anaguiar777/tcc-interface-musical-multissensorial/hardware/3d/README.md

# Invólucro 3D

Arquivos:

- `caixa_corpo.stl`
- `caixa_tampa.stl`

O corpo principal foi modelado para acomodar o conjunto eletrônico da unidade embarcada e a tampa permite acesso ao circuito para montagem e manutenção.

O desenvolvimento da geometria foi realizado de forma iterativa com apoio do ambiente Cursor durante a elaboração e os ajustes do modelo digital. As decisões de dimensão e adequação foram verificadas a partir dos componentes físicos do protótipo.

Envelope aproximado dos modelos:
- corpo: 84 × 64 × 52 mm;
- tampa: 84 × 64 × 5 mm.

As fotos da impressão e da disposição interna dos componentes serão adicionadas em `docs/fotos/`.

## Verificação dos arquivos originais

Após o upload, os arquivos podem ser conferidos pelos seguintes valores SHA-256:

| Arquivo | Tamanho | SHA-256 |
|---|---:|---|
| `caixa_corpo.stl` | 62.684 bytes | `c0678f162e2dd0e0683a15318d15398c387cd0960a7021f66101cb65fee5366b` |
| `caixa_tampa.stl` | 15.284 bytes | `076466b892219f54714d4bc5a69afdebfd9b1442e151f6ae7cfaafd1aea71c53` |

Esses hashes correspondem aos arquivos utilizados na documentação do projeto.
