anaguiar777/tcc-interface-musical-multissensorial/docs/fotos/README.md

# Fotografias do protótipo

Esta pasta será utilizada para documentar visualmente:

1. circuito em bancada;
2. ESP32 e estágio MOSFET;
3. sistema de baterias, BMS e MP1584EN;
4. caixa impressa em 3D;
5. disposição dos componentes dentro da caixa;
6. tampa e fechamento;
7. motor vibrotátil e LED;
8. unidade vestível final;
9. ensaio com MPD218.

Quando as fotografias forem adicionadas, o README principal poderá incorporar uma sequência visual de montagem.
