anaguiar777/tcc-interface-musical-multissensorial/hardware/BOM.md

# Lista de materiais

## Controlador e processamento
- 1 × Akai MPD218
- 1 × ESP32
- 1 × computador com Python 3
- rede Wi‑Fi local ou hotspot

## Canal vibrotátil
- 1 × motor Vibracall 1027
- 1 × MOSFET IRLZ44N
- 1 × resistor de 220 Ω
- 1 × resistor de 47 kΩ
- 1 × diodo Schottky 1N5819

## Canal visual
- 1 × LED de alto brilho
- 1 × resistor de 220 Ω

## Alimentação embarcada
- 2 × células Li‑ion 18650, 3,7 V nominal, em configuração 2S
- 1 × BMS 2S compatível
- 1 × conversor DC–DC MP1584EN
- fios, conectores e chave, conforme a montagem

## Invólucro
- 1 × corpo impresso a partir de `hardware/3d/caixa_corpo.stl`
- 1 × tampa impressa a partir de `hardware/3d/caixa_tampa.stl`

## Instrumentos recomendados para montagem
- multímetro
- fonte de bancada para os primeiros testes, se disponível
- ferro de solda
- computador com VS Code + PlatformIO

> Antes de alimentar o ESP32 pelo conversor DC–DC, ajuste e confira a tensão de saída com multímetro.
