anaguiar777/tcc-interface-musical-multissensorial/hardware/3d/caixa_tampa.stl

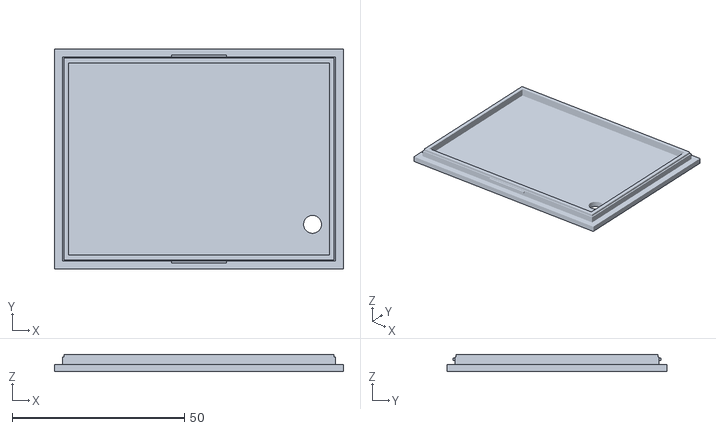
[picture p1: CAD file, 2026-10-28]
hardware/3d/caixa_tampa.stl
84.0 x 64.0 x 5.01
