anaguiar777/tcc-interface-musical-multissensorial/hardware/3d/caixa_corpo.stl

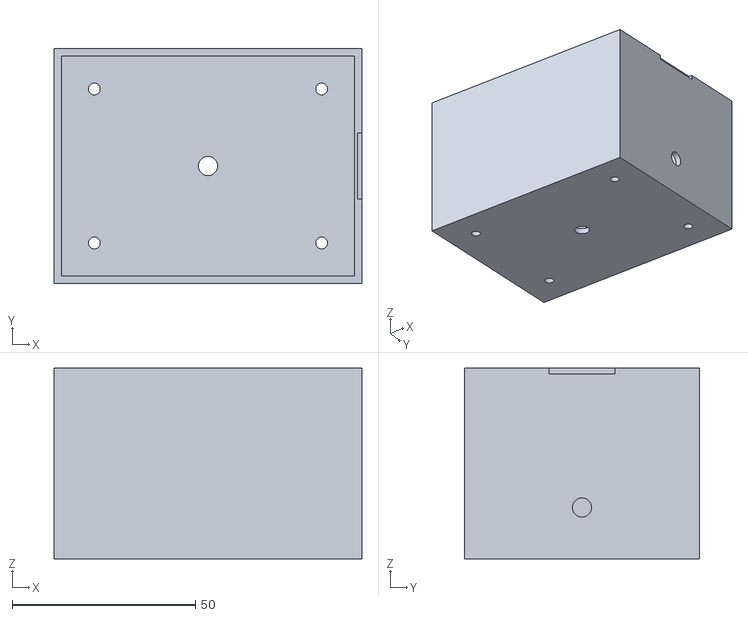
[picture p2: CAD file, 2026-10-28]
hardware/3d/caixa_corpo.stl
84.0 x 64.0 x 52.0
