anaguiar777/tcc-interface-musical-multissensorial/dados_experimentais/ensaio_acustico_resumo.csv

pwm | rep1_hz | rep2_hz | rep3_hz | media_hz | desvio_padrao_hz | coeficiente_variacao_percentual
80 | 91.5 | 92.9 | 90.2 | 91.5 | 1.35 | 1.5
115 | 106.3 | 127.9 | 126.5 | 120.2 | 12.09 | 10.1
150 | 145.3 | 154.8 | 165.5 | 155.2 | 10.11 | 6.5
185 | 173.6 | 191.1 | 196.5 | 187.1 | 11.97 | 6.4
220 | 203.2 | 212.6 | 216.7 | 210.8 | 6.92 | 3.3
255 | 224.8 | 227.4 | 231.5 | 227.9 | 3.38 | 1.5
