anaguiar777/tcc-interface-musical-multissensorial/dados_experimentais/ensaio_queda_resumo.csv

altura_cm | energia_potencial_J | velocity_media | velocity_mediana | velocity_desvio_padrao | pwm_media | pwm_desvio_padrao | repiques_ignorados | velocity_127
0.5 | 0.001912 | 38.6 | 41.0 | 19.91 | 132.2 | 27.61 | 0 | 0
1.0 | 0.003825 | 76.9 | 87.0 | 26.49 | 185.5 | 36.70 | 4 | 0
2.0 | 0.007649 | 99.4 | 102.0 | 9.29 | 216.6 | 12.93 | 8 | 0
3.0 | 0.011474 | 108.5 | 111.0 | 5.56 | 229.3 | 7.90 | 7 | 0
4.0 | 0.015298 | 116.3 | 118.5 | 7.72 | 240.0 | 10.61 | 4 | 0
5.0 | 0.019123 | 124.5 | 124.5 | 2.01 | 251.4 | 2.88 | 3 | 3
