anaguiar777/tcc-interface-musical-multissensorial/(commit log)

2026-10-28 Estrutura guia publico de reproducao do prototipo
2026-10-28 Adiciona hardware/BOM.md
2026-10-28 Adiciona dados_experimentais/ensaio_queda_resumo.csv
    [ensaio_queda_resumo.csv]
2026-10-28 Adiciona dados_experimentais/ensaio_acustico_resumo.csv
    [ensaio_acustico_resumo.csv]
2026-10-28 Fixa versao do framework ESP32 para reproducibilidade
2026-10-28 Adiciona hashes de integridade dos modelos STL
2026-10-28 Arquivos para caixa de invólucro
    [caixa_corpo.stl, caixa_tampa.stl]
2026-11-03 Etapa 5: corrige README e caminhos de reprodução
